G-only1/Mini-Macro-Pad-V3-Hardware/(list of files, cad)

Other CAD files:
Case CAD Files/Base REV 1.0.ipt
Case CAD Files/Base.ipt
Case CAD Files/Mini Macro Pad V3 Case REV 1.0.iam
Case CAD Files/OldVersions/Base REV 1.0.0008.ipt
