G-only1/Mini-Macro-Pad-V3-Hardware/KiCad Project/Mini Macro Pad V3 PCB.kicad_pcb

## KiCad design KiCad Project/Mini Macro Pad V3 PCB.kicad_pcb (2025-11-12)

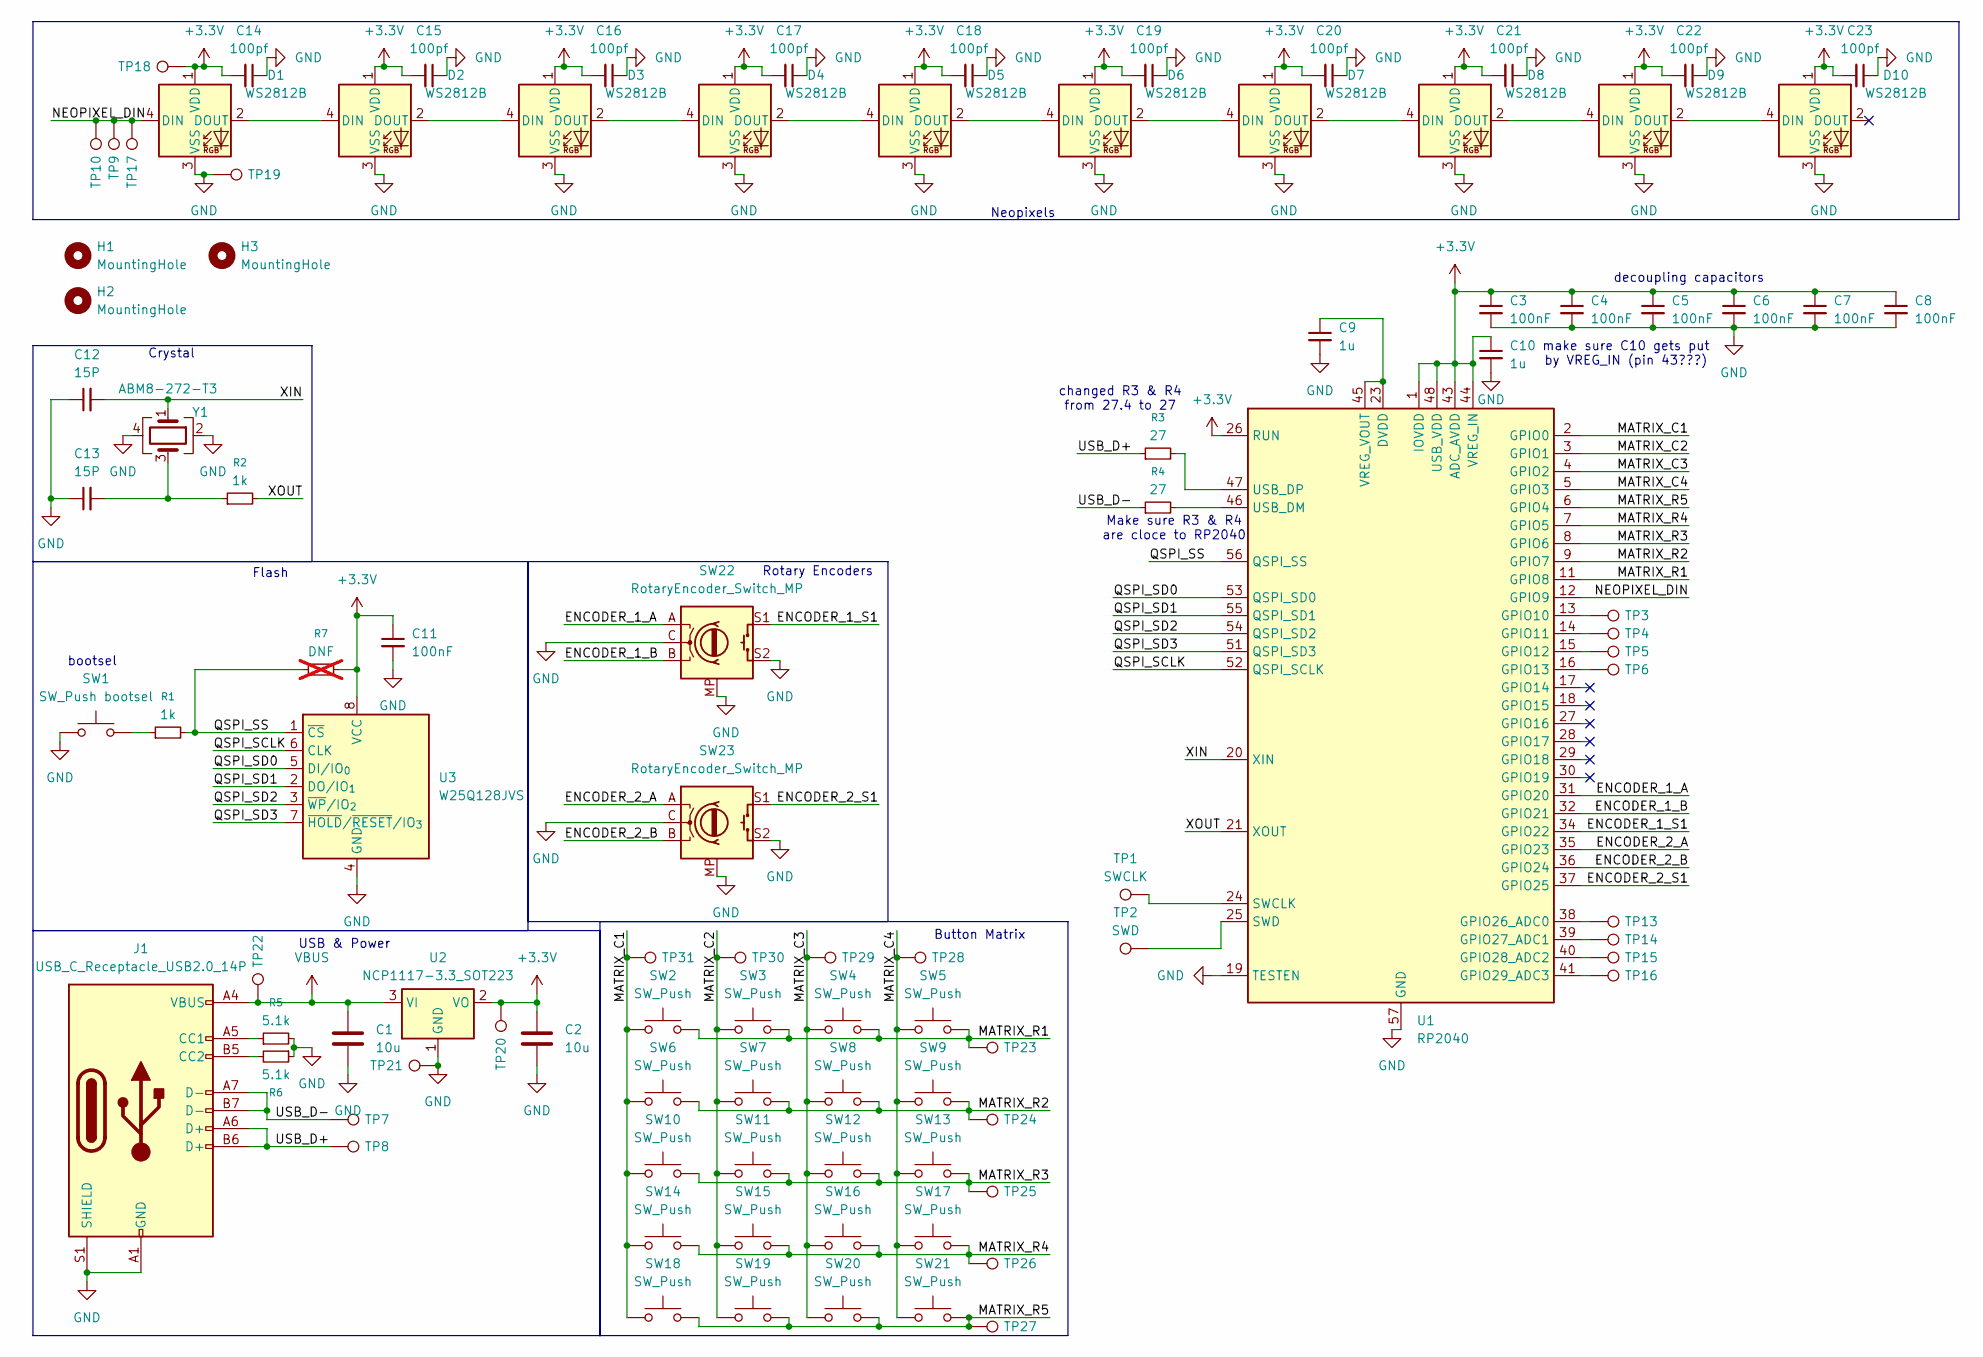
[picture p1: schematic Mini Macro Pad V3 PCB.kicad_sch, Mini Macro Pad V3]

Parts:
C1, C2: 10u; C_0603_1608Metric
C3, C4, C5, C6, C7, C8, C11: 100nF; C_0603_1608Metric
C9, C10: 1u; C_0603_1608Metric
C12, C13: 15P; C_0603_1608Metric
C14, C15, C16, C17, C18, C19, C20, C21, C22, C23: 100pf; C_0603_1608Metric
D1, D2, D3, D4, D5, D6, D7, D8, D9, D10: WS2812B; LED_WS2812B_PLCC4_5.0x5.0mm_P3.2mm
H1, H2, H3: MountingHole; ToolingHole_1.152mm
J1: USB_C_Receptacle_USB2.0_14P; USB_C_Receptacle_GCT_USB4105-xx-A_16P_TopMnt_Horizontal
R1, R2: 1k; R_0603_1608Metric
R3, R4: 27; R_0603_1608Metric
R5, R6: 5.1k; R_0603_1608Metric
R7: DNF; R_0402_1005Metric_Pad0.72x0.64mm_HandSolder; not fitted
SW1: SW_Push bootsel; SW_PUSH_6mm_H5mm
SW2, SW3, SW4, SW5, SW6, SW7, SW8, SW9, SW10, SW11, SW12, SW13, SW14, SW15, SW16, SW17, SW18, SW19, SW20, SW21: SW_Push; SW_PUSH_6mm_H5mm
SW22, SW23: RotaryEncoder_Switch_MP; RotaryEncoder_Bourns_Horizontal_PEC12R-2x17F-Sxxxx
TP1: SWCLK; TestPoint_Pad_1.5x1.5mm
TP2: SWD; TestPoint_Pad_1.5x1.5mm
TP3, TP4, TP5, TP6, TP7, TP8, TP9, TP10, TP13, TP14, TP15, TP16, TP17, TP18, TP19, TP20, TP21, TP22, TP23, TP24, TP25, TP26, TP27, TP28, TP29, TP30, TP31: TestPoint_Pad_1.5x1.5mm
U1: RP2040; QFN-56-1EP_7x7mm_P0.4mm_EP3.2x3.2mm_ThermalVias
U2: NCP1117-3.3_SOT223; SOT-223-3_TabPin2
U3: W25Q128JVS; SOIC-8_5.3x5.3mm_P1.27mm
Y1: ABM8-272-T3; ABM8-272-T3_ABR

Connections:
+3.3V: C2.1, C3.1, C4.1, C5.1, C6.1, C7.1, C8.1, C10.1, C11.1, C14.2, C15.2, C16.2, C17.2, C18.2, C19.2, C20.2, C21.2, C22.2, C23.2, D1.1 (VDD), D2.1 (VDD), D3.1 (VDD), D4.1 (VDD), D5.1 (VDD), D6.1 (VDD), D7.1 (VDD), D8.1 (VDD), D9.1 (VDD), D10.1 (VDD), R7.2, TP18.1, TP20.1, U1.1 (IOVDD), U1.10 (IOVDD), U1.22 (IOVDD), U1.26 (RUN), U1.33 (IOVDD), U1.42 (IOVDD), U1.43 (ADC_AVDD), U1.44 (VREG_IN), U1.48 (USB_VDD), U1.49 (IOVDD), U2.2 (VO), U3.8 (VCC)
/ENCODER_1_A: SW22.A, U1.31 (GPIO20)
/ENCODER_1_B: SW22.B, U1.32 (GPIO21)
/ENCODER_1_S1: SW22.S1, U1.34 (GPIO22)
/ENCODER_2_A: SW23.A, U1.35 (GPIO23)
/ENCODER_2_B: SW23.B, U1.36 (GPIO24)
/ENCODER_2_S1: SW23.S1, U1.37 (GPIO25)
/MATRIX_C1: SW2.1, SW6.1, SW10.1, SW14.1, SW18.1, TP31.1, U1.2 (GPIO0)
/MATRIX_C2: SW3.1, SW7.1, SW11.1, SW15.1, SW19.1, TP30.1, U1.3 (GPIO1)
/MATRIX_C3: SW4.1, SW8.1, SW12.1, SW16.1, SW20.1, TP29.1, U1.4 (GPIO2)
/MATRIX_C4: SW5.1, SW9.1, SW13.1, SW17.1, SW21.1, TP28.1, U1.5 (GPIO3)
/MATRIX_R1: SW2.2, SW3.2, SW4.2, SW5.2, TP23.1, U1.11 (GPIO8)
/MATRIX_R2: SW6.2, SW7.2, SW8.2, SW9.2, TP24.1, U1.9 (GPIO7)
/MATRIX_R3: SW10.2, SW11.2, SW12.2, SW13.2, TP25.1, U1.8 (GPIO6)
/MATRIX_R4: SW14.2, SW15.2, SW16.2, SW17.2, TP26.1, U1.7 (GPIO5)
/MATRIX_R5: SW18.2, SW19.2, SW20.2, SW21.2, TP27.1, U1.6 (GPIO4)
/NEOPIXEL_DIN: D1.4 (DIN), TP9.1, TP10.1, TP17.1, U1.12 (GPIO9)
/QSPI_SCLK: U1.52 (QSPI_SCLK), U3.6 (CLK)
/QSPI_SD0: U1.53 (QSPI_SD0), U3.5 (DI/IO_{0})
/QSPI_SD1: U1.55 (QSPI_SD1), U3.2 (DO/IO_{1})
/QSPI_SD2: U1.54 (QSPI_SD2), U3.3 (~WP/IO_{2})
/QSPI_SD3: U1.51 (QSPI_SD3), U3.7 (~HOLD/~RESET/IO_{3})
/QSPI_SS: R1.2, R7.1, U1.56 (QSPI_SS), U3.1 (~CS)
/USB_D+: J1.A6 (D+), J1.B6 (D+), R3.1, TP8.1
/USB_D-: J1.A7 (D-), J1.B7 (D-), R4.1, TP7.1
/XIN: C12.2, U1.20 (XIN), Y1.1
/XOUT: R2.2, U1.21 (XOUT)
GND: C1.2, C2.2, C3.2, C4.2, C5.2, C6.2, C7.2, C8.2, C9.2, C10.2, C11.2, C12.1, C13.1, C14.1, C15.1, C16.1, C17.1, C18.1, C19.1, C20.1, C21.1, C22.1, C23.1, D1.3 (VSS), D2.3 (VSS), D3.3 (VSS), D4.3 (VSS), D5.3 (VSS), D6.3 (VSS), D7.3 (VSS), D8.3 (VSS), D9.3 (VSS), D10.3 (VSS), J1.A1 (GND), J1.A12 (GND), J1.B1 (GND), J1.B12 (GND), J1.S1 (SHIELD), R5.2, R6.1, SW1.1, SW22.C, SW22.MP, SW22.S2, SW23.C, SW23.MP, SW23.S2, TP19.1, TP21.1, U1.19 (TESTEN), U1.57 (GND), U2.1 (GND), U3.4 (GND), Y1.2, Y1.4
unnamed: C13.2, R2.1, Y1.3
unnamed: D1.2 (DOUT), D2.4 (DIN)
unnamed: D2.2 (DOUT), D3.4 (DIN)
unnamed: D3.2 (DOUT), D4.4 (DIN)
unnamed: D4.2 (DOUT), D5.4 (DIN)
unnamed: D5.2 (DOUT), D6.4 (DIN)
unnamed: D6.2 (DOUT), D7.4 (DIN)
unnamed: D7.2 (DOUT), D8.4 (DIN)
unnamed: D8.2 (DOUT), D9.4 (DIN)
unnamed: D9.2 (DOUT), D10.4 (DIN)
unnamed: J1.A5 (CC1), R5.1
unnamed: J1.B5 (CC2), R6.2
unnamed: R1.1, SW1.2
unnamed: TP3.1, U1.13 (GPIO10)
unnamed: TP4.1, U1.14 (GPIO11)
unnamed: TP5.1, U1.15 (GPIO12)
unnamed: TP6.1, U1.16 (GPIO13)
unnamed: TP13.1, U1.38 (GPIO26_ADC0)
unnamed: TP14.1, U1.39 (GPIO27_ADC1)
unnamed: TP15.1, U1.40 (GPIO28_ADC2)
unnamed: TP16.1, U1.41 (GPIO29_ADC3)
unnamed: TP1.1, U1.24 (SWCLK)
unnamed: TP2.1, U1.25 (SWD)
unnamed: R4.2, U1.46 (USB_DM)
unnamed: R3.2, U1.47 (USB_DP)
unnamed: C9.1, U1.23 (DVDD), U1.45 (VREG_VOUT), U1.50 (DVDD)
VBUS: C1.1, J1.A4 (VBUS), J1.A9 (VBUS), J1.B4 (VBUS), J1.B9 (VBUS), TP22.1, U2.3 (VI)

Notes on the sheet:
bootsel
Flash
USB & Power
Button Matrix
Crystal
Make sure R3 & R4 are cloce to RP2040
Rotary Encoders
make sure C10 gets put by VREG_IN (pin 43???)
decoupling capacitors
Neopixels
changed R3 & R4 from 27.4 to 27

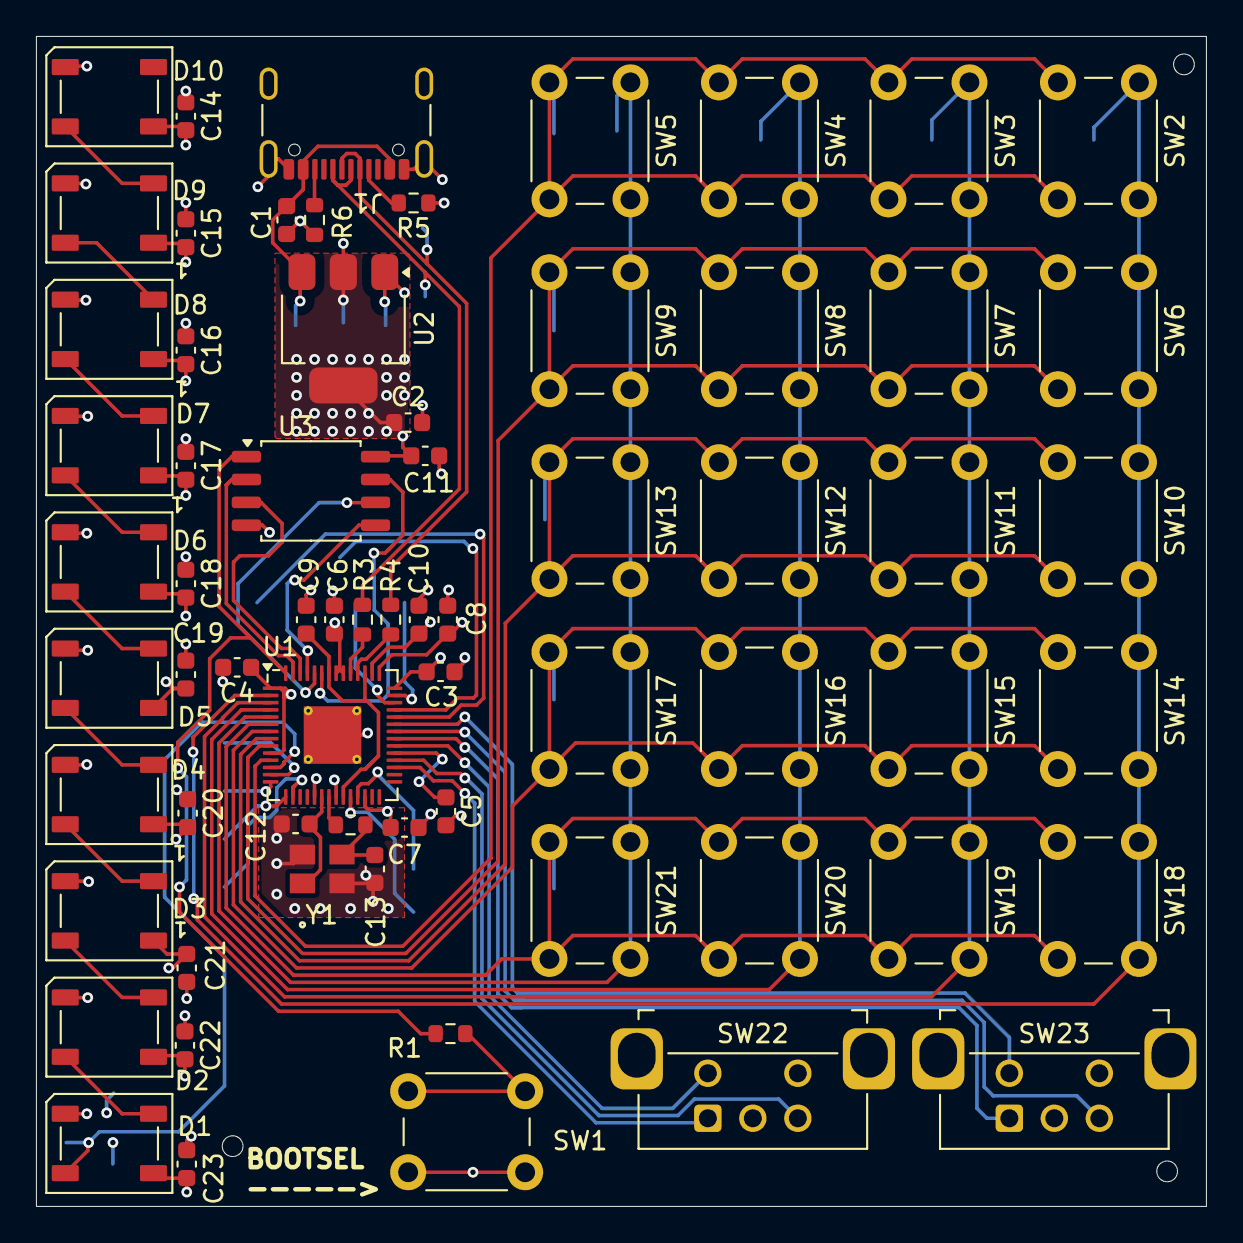
[picture p2: board Mini Macro Pad V3 PCB.kicad_pcb from above]

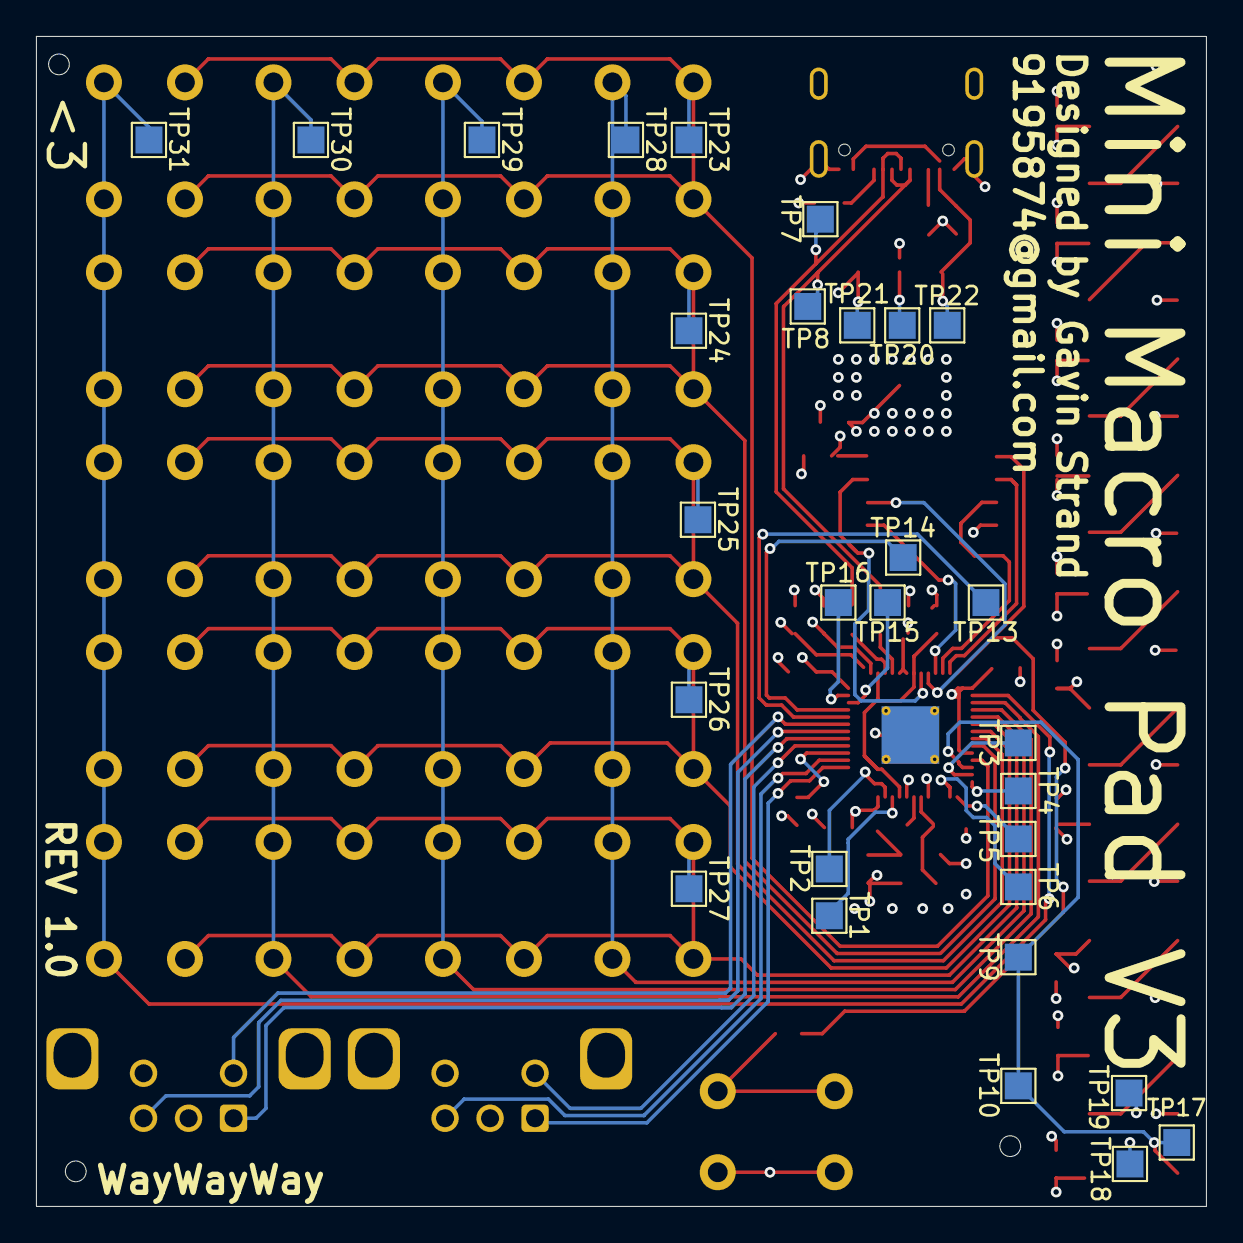
[picture p3: board Mini Macro Pad V3 PCB.kicad_pcb from below]

Board: 4 copper layers, 65.0 x 65.0 mm, 99 parts (29 on the bottom side), 55 nets.
