G-only1/Mini-Macro-Pad-V3-Hardware/(commit log)

2025-07-19 Created kicad project
    [Mini Macro Pad V3 PCB.kicad_pcb, Mini Macro Pad V3 PCB.kicad_sch]
2025-07-19 moved kicad project to its own folder.
    [Mini Macro Pad V3 PCB.kicad_pcb, Mini Macro Pad V3 PCB.kicad_sch]
2025-07-19 added basic components & neopixels to schematic
    just adding base components to schematic. not really any wiring yet
    [Mini Macro Pad V3 PCB.kicad_sch]
2025-07-19 added details to title block & added power supply
    power supply copied from page 7 of the raspberry pi hardware design guide for the rp2040 https://datasheets.raspberrypi.com/rp2040/hardware-design-with-rp2040.pdf
2025-07-19 same thing as previous commit
    https://datasheets.raspberrypi.com/rp2040/hardware-design-with-rp2040.pdf
    [Mini Macro Pad V3 PCB.kicad_sch]
2025-07-19 added flash to schematic
    [Mini Macro Pad V3 PCB.kicad_sch]
2025-07-19 added crystal to schematic
    [Mini Macro Pad V3 PCB.kicad_sch]
2025-07-19 added footprint for crystal
    [Mini Macro Pad V3 PCB.kicad_sch]
2025-07-19 added button matrix
    button matrix columns are connected to GPIO 0 to GPIO 3 rows are connected to GPIO 4 to GPIO 8
    [Mini Macro Pad V3 PCB.kicad_sch]
2025-07-19 added rotary encoders
    connected to GPIO 10 to GPIO 15
    [Mini Macro Pad V3 PCB.kicad_sch]
2025-07-19 assigned footprints to neopixels
    [Mini Macro Pad V3 PCB.kicad_sch]
2025-07-19 added to usb power
    added 5.1k resistors to CC1 & CC2
    [Mini Macro Pad V3 PCB.kicad_sch]
2025-07-19 Assigned footprints to all components
    [Mini Macro Pad V3 PCB.kicad_sch]
2025-07-19 created PCB & did rough layout
    [Mini Macro Pad V3 PCB.kicad_pcb, Mini Macro Pad V3 PCB.kicad_sch]
2025-07-19 more rough layout
    [Mini Macro Pad V3 PCB.kicad_pcb]
2025-07-20 added test points & fixed layout issues with buttons
    some buttons were numbered in the wrong order.
    [Mini Macro Pad V3 PCB.kicad_pcb, Mini Macro Pad V3 PCB.kicad_sch]
2025-07-20 changed GPIO pins used
    moved rotary encoder GPIO pins away from the pins used for the crystal to prevent stability issues
    [Mini Macro Pad V3 PCB.kicad_pcb, Mini Macro Pad V3 PCB.kicad_sch]
2025-07-20 added decoupling capacitors for neopixels
    [Mini Macro Pad V3 PCB.kicad_pcb, Mini Macro Pad V3 PCB.kicad_sch]
2025-07-20 Started drawing traces
    [Mini Macro Pad V3 PCB.kicad_pcb, Mini Macro Pad V3 PCB.kicad_sch]
2025-07-20 changed some GPIO connections & did more trace routing
    Reversed the order that C1 to C5 connect in
    [Mini Macro Pad V3 PCB.kicad_pcb, Mini Macro Pad V3 PCB.kicad_sch]
2025-07-21 more routing traces.
    [Mini Macro Pad V3 PCB.kicad_pcb, Mini Macro Pad V3 PCB.kicad_sch]
2025-07-21 added ground and power planes
    [Mini Macro Pad V3 PCB.kicad_pcb]
2025-07-21 added vias to connect components to ground & power planes
    [Mini Macro Pad V3 PCB.kicad_pcb]
2025-07-21 more routing work
    [Mini Macro Pad V3 PCB.kicad_pcb, Mini Macro Pad V3 PCB.kicad_sch]
2025-07-21 tweaks for DRC
    [Mini Macro Pad V3 PCB.kicad_pcb, Mini Macro Pad V3 PCB.kicad_sch]
2025-07-21 added silkscreen things
    [Mini Macro Pad V3 PCB.kicad_pcb, Mini Macro Pad V3 PCB.kicad_sch]
2025-07-21 moved USB C port to the right more
    [Mini Macro Pad V3 PCB.kicad_pcb]
2025-07-21 small tweaks before ordering first prototype
    [Mini Macro Pad V3 PCB.kicad_pcb, Mini Macro Pad V3 PCB.kicad_sch]
2025-07-22 changed capacitor & resistor sizes
    changed sizes from 0402 to 0603 & replaced BOOTSEL button with the same kind as all the others
    [Mini Macro Pad V3 PCB.kicad_pcb, Mini Macro Pad V3 PCB.kicad_sch]
2025-07-22 small tweaks before ordering
    [Mini Macro Pad V3 PCB.kicad_pcb, Mini Macro Pad V3 PCB.kicad_sch]
2025-07-23 Changed USB C footprint
    changed because of part availability.
    [Mini Macro Pad V3 PCB.kicad_pcb]
2025-07-23 final save before first prototype order
    [Mini Macro Pad V3 PCB.kicad_pcb]
2025-07-25 created folder for case files
    created a new folder for the case cad files & exported a step file of the REV 1.0 PCB
    [Mini Macro Pad V3 Case REV 1.0.iam]
2025-07-26 some case base design
    [Base REV 1.0.0008.ipt, Base REV 1.0.ipt, Base.ipt]
2025-07-26 removed holes smaller than .2mm
    [Mini Macro Pad V3 PCB.kicad_pcb]
2025-07-26 Replaced all micro vias with through vias
    [Mini Macro Pad V3 PCB.kicad_pcb]
2025-11-12 fixed issue with C9 & C10 in schematic
    C9 and C10 were connected in series with a line when they should've been connected in parallel between the line and ground
    [Mini Macro Pad V3 PCB.kicad_sch]
2025-11-12 changed PCB to reflect changes in schematic
    [Mini Macro Pad V3 PCB.kicad_pcb]
